hobbyquaker/ebr/case/ebr-case.stl

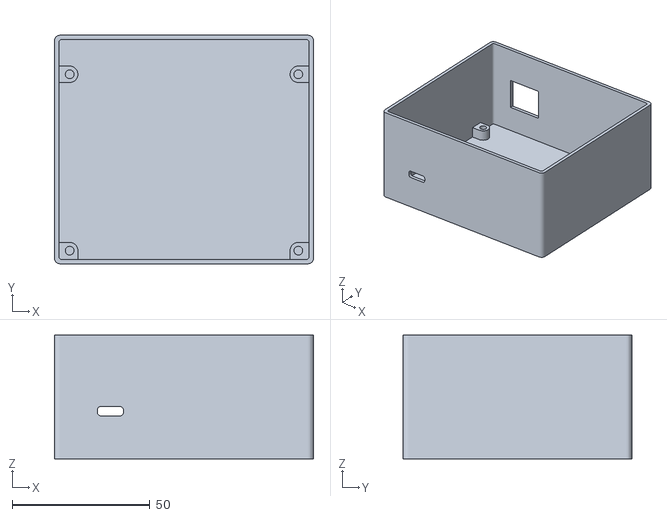
[picture p4: CAD file, 2026-10-26]
case/ebr-case.stl
94.0 x 83.0 x 45.0
