hobbyquaker/ebr/case/ebr-lid.stl

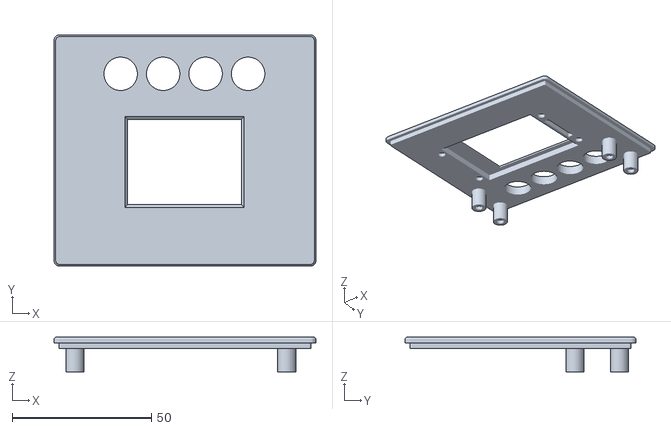
[picture p5: CAD file, 2026-10-26]
case/ebr-lid.stl
94.0 x 83.0 x 12.4
