hobbyquaker/ebr/(list of files, cad)

Other CAD files:
case/ebr-case.f3d
case/ebr-lid.f3d
